InScene/lora_flood_sensor_batterie/doc/circuit diagram.png

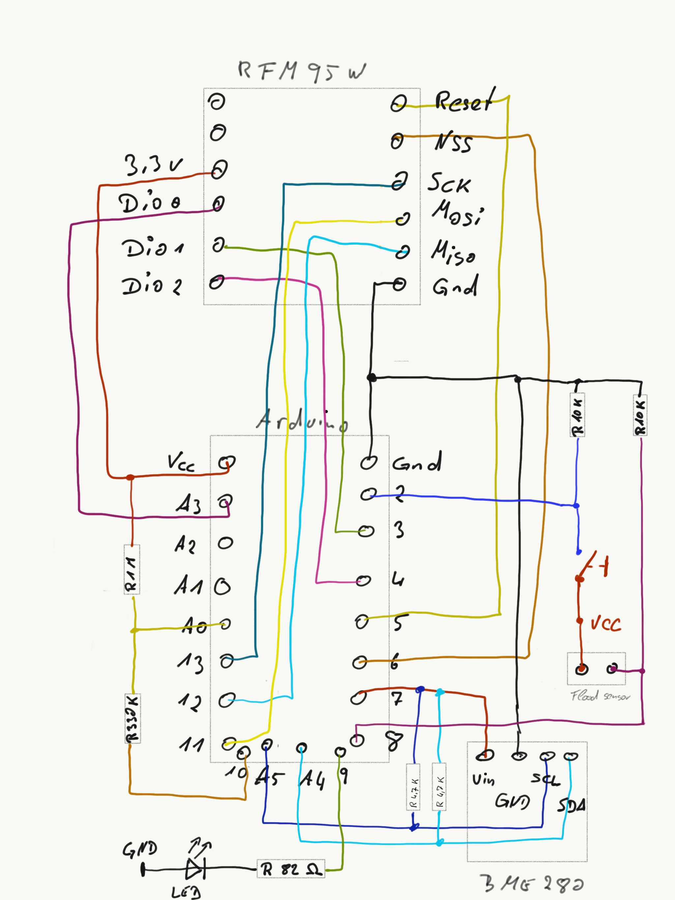
doc/circuit diagram.png
