InScene/lora_flood_sensor_batterie/doc/HW_changes.txt

Arduino Pro Mini hw changes for low power:
http://www.home-automation-community.com/arduino-low-power-how-to-run-atmega328p-for-a-year-on-coin-cell-battery/
