InScene/lora_flood_sensor_batterie/(commit log)

2020-10-06 Button added
2020-10-08 Button debounced and internal pullup resistor deactivated to save battery
2020-10-08 Button comments changed
2020-10-08 Data storage for send interval and high temperature threshold rebuild
2020-10-08 Max count in failsafe is now changeable during runtime
    [failsafe.cpp, failsafe.h]
2020-10-08 Add led code
2020-10-09 Serial print from floodsensor removed
2020-10-09 Failsaife reset function activate and serial print deactivated
    [failsafe.cpp, failsafe.h]
2020-10-09 Serial print removed from datastorage
2020-10-09 BME280 sensor changed to force mode to save batterie. Also data fetch functions expanded
2020-10-09 Added time class to calculate the runtime, because of the deep sleep the time tracking does not work.
    [flooddetector_batterie.ino, time.cpp, time.h]
2020-10-09 Remove magic number and rename reset failsafe
    [flooddetector_batterie.ino]
2020-10-11 Battery measurement now switchable to save power
2020-10-11 Failsafe changed from counting calls to time check
    [failsafe.cpp, failsafe.h]
2020-10-11 Circuit and main software changed
